Chris-Johnston/santacaws/readme.md

# Santa CAWs

More novelty circuitboards, powered by an ATTINY404.

lazy image of the boards
