Chris-Johnston/santacaws/pcb/santa-caws.kicad_pcb

## KiCad design pcb/santa-caws.kicad_pcb (2025-02-22)

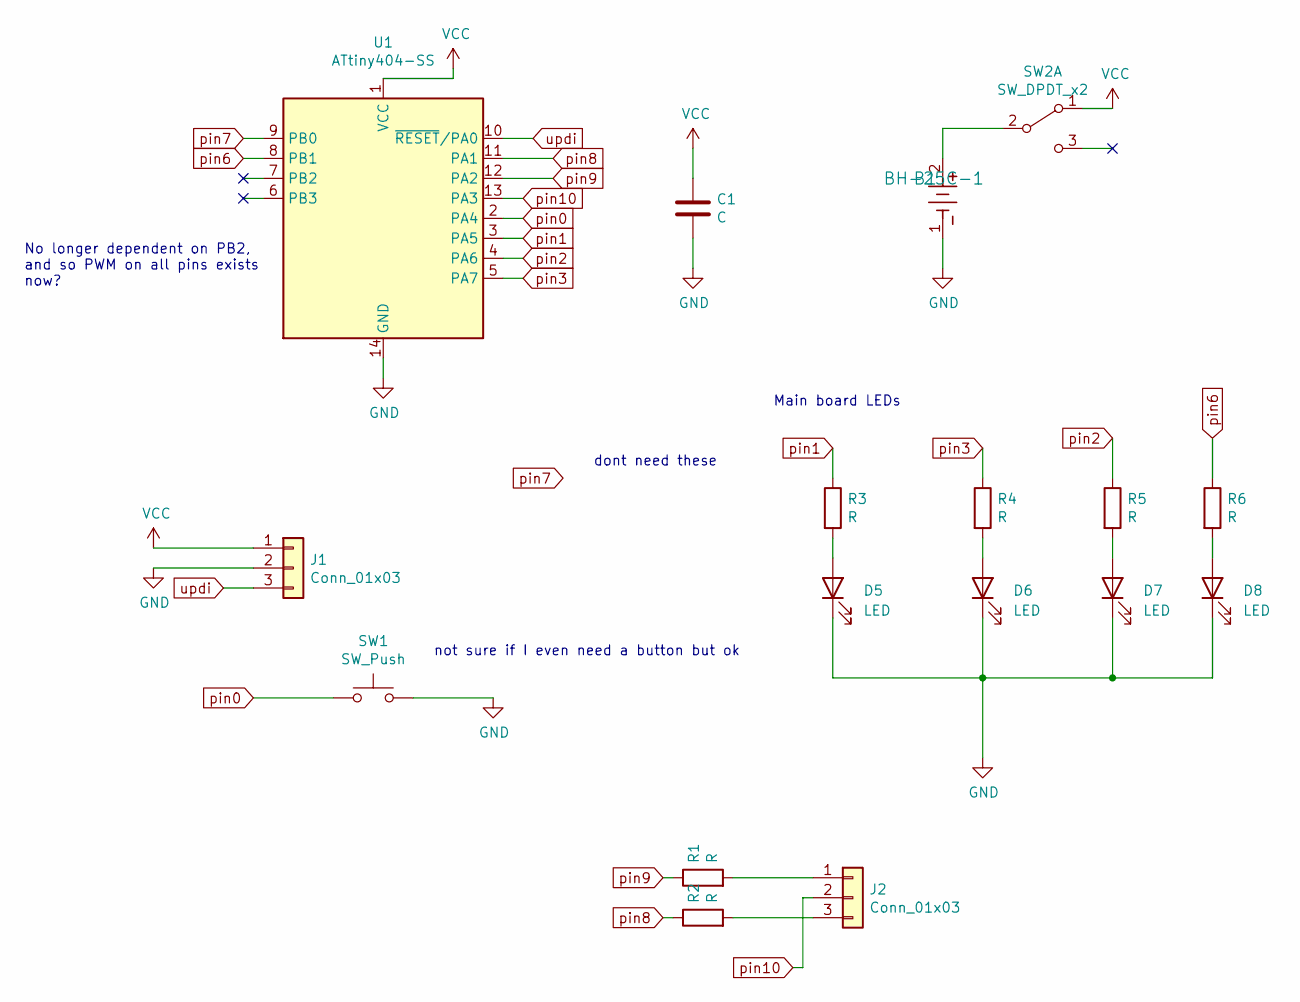
[picture p1: schematic santa-caws.kicad_sch]

Parts:
B1: BH-25C-1; BH-25C-1_ADM
C1: C; C_1206_3216Metric_Pad1.33x1.80mm_HandSolder
D5, D6, D7, D8: LED; Custom_LessSilkscreenLED_1206_3216Metric_Pad1.42x1.75mm_Han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
J1: Conn_01x03; custom_updipad_PinHeader_1x03_P2.54mm_Vertical
J2: Conn_01x03; PinSocket_1x03_P2.54mm_Horizontal
R1, R2, R3, R4, R5, R6: R; R_1206_3216Metric_Pad1.30x1.75mm_HandSolder
SW1: SW_Push; SW_Push_1P1T_NO_6x6mm_H9.5mm
SW2: SW_DPDT_x2; SW_SPDT_CK-JS102011SAQN
U1: ATtiny404-SS; SOIC-14_3.9x8.7mm_P1.27mm

Connections:
GND: B1.1, C1.2, D5.1 (K), D6.1 (K), D7.1 (K), D8.1 (K), J1.2, SW1.2, U1.14 (GND)
unnamed: B1.2, SW2.2 (B)
unnamed: D5.2 (A), R3.2
unnamed: D6.2 (A), R4.2
unnamed: D7.2 (A), R5.2
unnamed: D8.2 (A), R6.2
unnamed: J2.1, R1.2
unnamed: J2.3, R2.2
VCC: C1.1, J1.1, SW2.1 (A), U1.1 (VCC)
pin0: SW1.1, U1.2 (PA4)
pin1: R3.1, U1.3 (PA5)
pin2: R5.1, U1.4 (PA6)
pin3: R4.1, U1.5 (PA7)
pin6: R6.1, U1.8 (PB1)
pin7: U1.9 (PB0)
pin8: R2.1, U1.11 (PA1)
pin9: R1.1, U1.12 (PA2)
pin10: J2.2, U1.13 (PA3)
updi: J1.3, U1.10 (~RESET/PA0)

Notes on the sheet:
not sure if I even need a button but ok
No longer dependent on PB2, and so PWM on all pins exists now?
dont need these
Main board LEDs

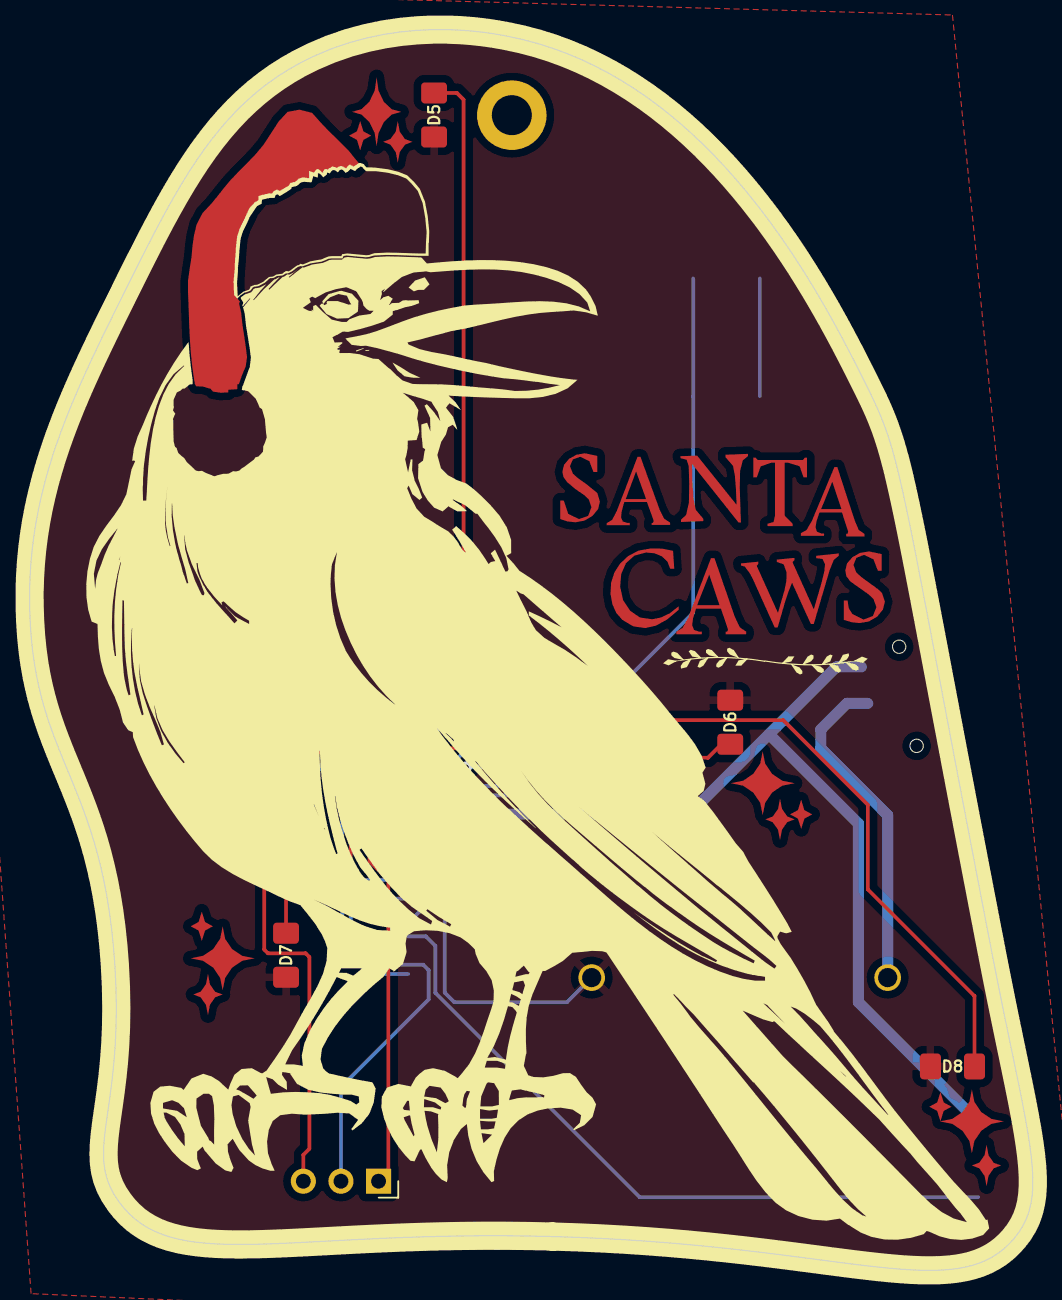
[picture p2: board santa-caws.kicad_pcb from above]

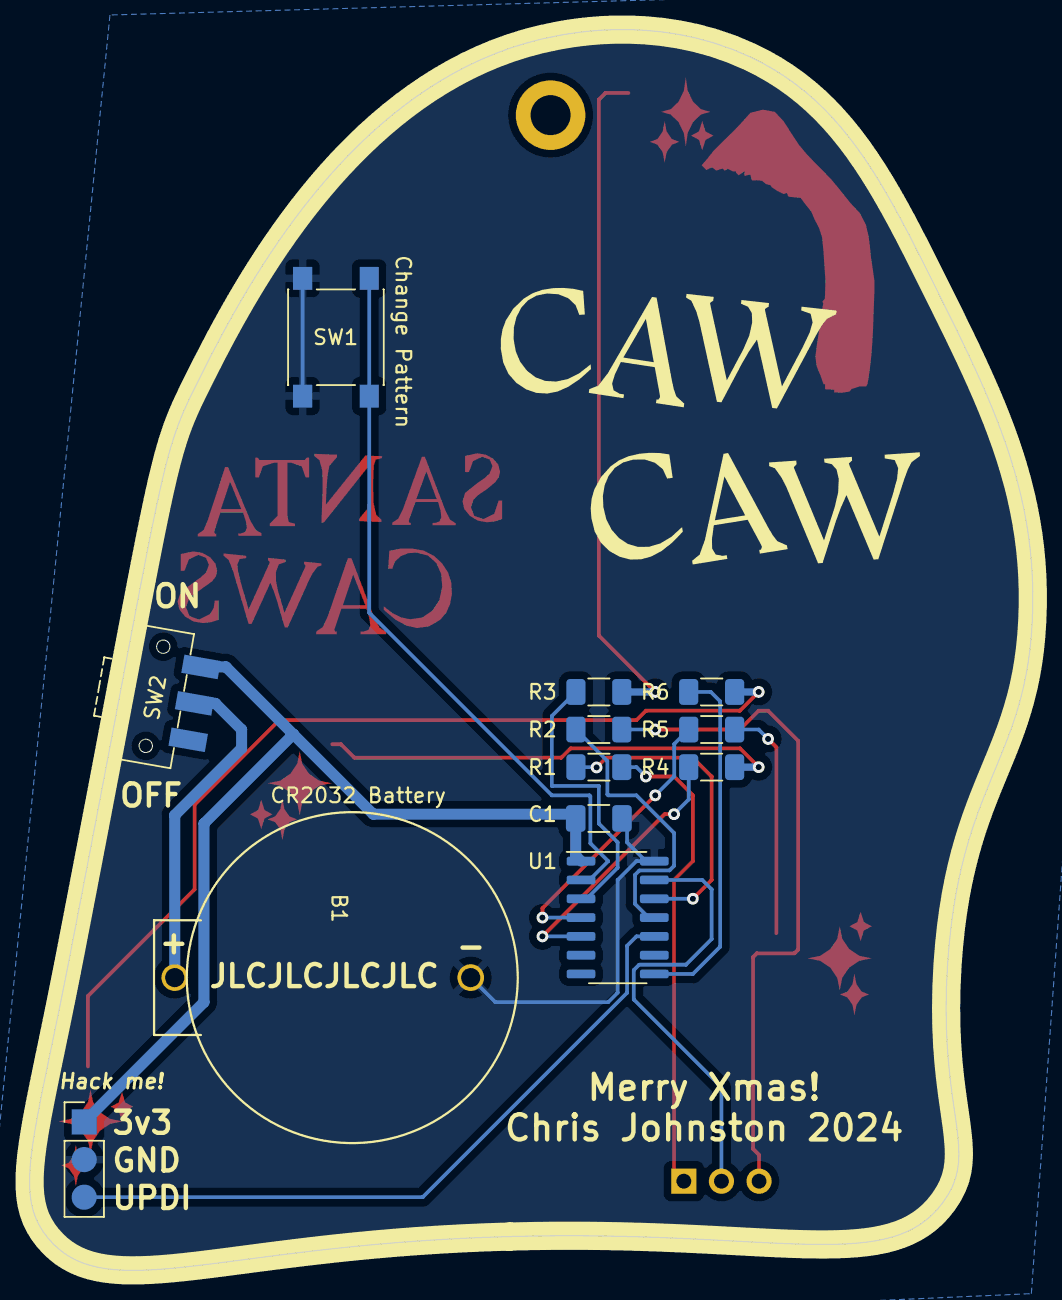
[picture p3: board santa-caws.kicad_pcb from below]

Board: 2 copper layers, 67.8 x 83.8 mm, 18 parts (12 on the bottom side), 18 nets.

Other parts of the board:
svg2mod: G***; santa-caws_128dpi
