Chris-Johnston/santacaws/trinketboards/bottlecap/bottlecap.kicad_pcb

## KiCad design trinketboards/bottlecap/bottlecap.kicad_pcb (2025-02-22)

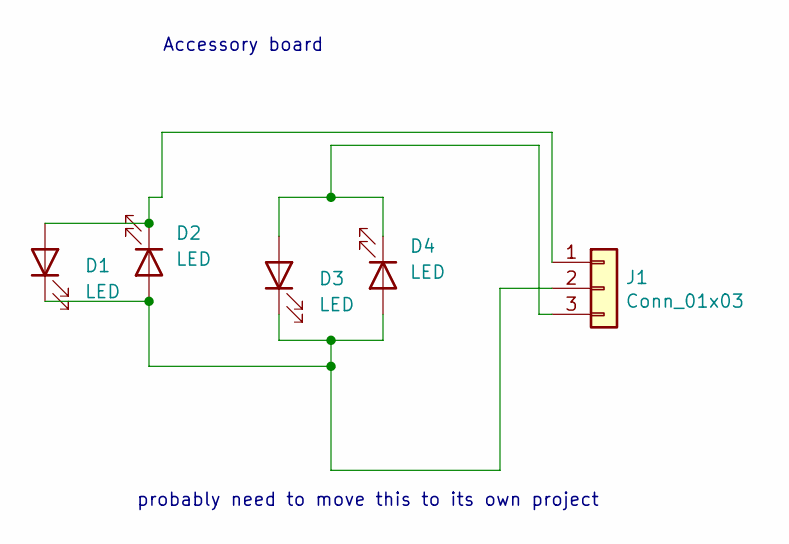
[picture p4: schematic bottlecap.kicad_sch]

Parts:
D1, D2, D3, D4: LED; Custom_LessSilkscreenLED_1206_3216Metric_Pad1.42x1.75mm_Han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
J1: Conn_01x03; PinHeader_1x03_P2.54mm_Horizontal

Connections:
unnamed: D1.1 (K), D2.2 (A), D3.1 (K), D4.2 (A), J1.2
unnamed: D1.2 (A), D2.1 (K), J1.1
unnamed: D3.2 (A), D4.1 (K), J1.3

Notes on the sheet:
probably need to move this to its own project
Accessory board

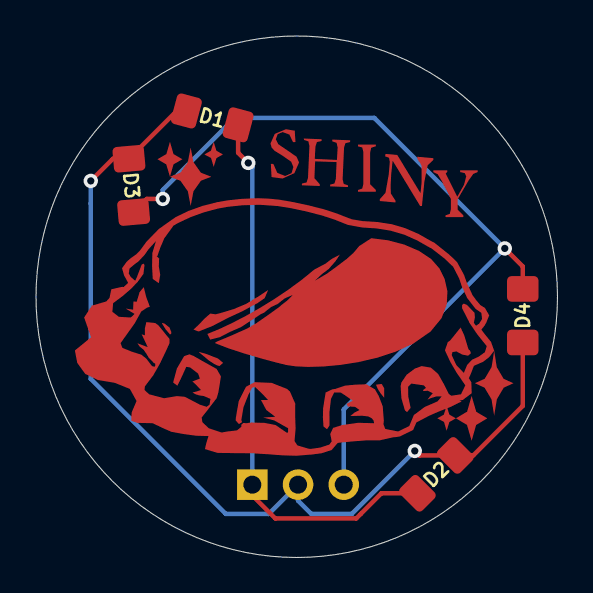
[picture p5: board bottlecap.kicad_pcb from above]

Board: 2 copper layers, 29.0 x 29.0 mm, 6 parts (1 on the bottom side), 3 nets.

Other parts of the board:
svg2mod: G***; trinket-bottlecap-inkscape
